scottlbaker/WSPR-beacon/README.md

## Summary

WSPR Beacon

## Description

A WSPR beacon for Arduino and Si5351.

rev0: manually set band using CAT commands

rev1: automatically set band based on band module configuration

## Contributors

* Scott L Baker

## Resources

You can check if your call was received by other stations here:
http://wsprnet.org/drupal/wsprnet/spotquery

## License

See the **LICENSE** file in this repository
