scottlbaker/WSPR-beacon/rev0/hardware/usdx-BOM.xls

Designator | Comment | Footprint | Quantity | Part Number
C1,C2,C3,C4,C5,C14 | 47uF | 8-1206 | 6 | C403725
C6,C7,C9,C10,C11,C12,C13,C15,C17 | .1uF | 3-0603 | 9 | C113803
C8,C16,C18,C19,C20,C21,C22,C23 | 10uF | 3-0603 | 8 | C344022
D1 | LED | 3-0603 | 1 | C434419
D2 | 1SMA4756 | ZENER-DO214 | 1 | C438374
D3 | SS14 | SOD123 | 1 | C2909920
J3 | USB-C | USB-C | 1 | C2765186
L2 | 100uH | 6-0805 | 1 | C223180
R1,R3 | 10.0K | 3-0603 | 2 | C191318
R2 | 1K | 3-0603 | 1 | C14676
R4 | 2.2K | 3-0603 | 1 | C4190
R5,R6 | 3.3K | 3-0603 | 2 | C22978
S1 | Push Button | PB1 | 1 | C221880
U1 | ATMEGA328 | ATMEG328 | 1 | C14877
U3 | 74ACT244 | TSSOP-20 | 1 | C6930
U4 | Si5351A | MSOP-10 | 1 | C1509083
U5 | XC6206-3.3 | SOT23-3 | 1 | C347376
U6 | CH340E | MSOP-10 | 1 | C99652
U7 | AMS1117-5 | SOT-223 | 1 | C6187
Y1 | 16MHz | Xtal_SMT1 | 1 | C13738
Y2 | 25MHz | Xtal_SMT | 1 | C9006
