scottlbaker/WSPR-beacon/rev0/hardware/schematic.pdf

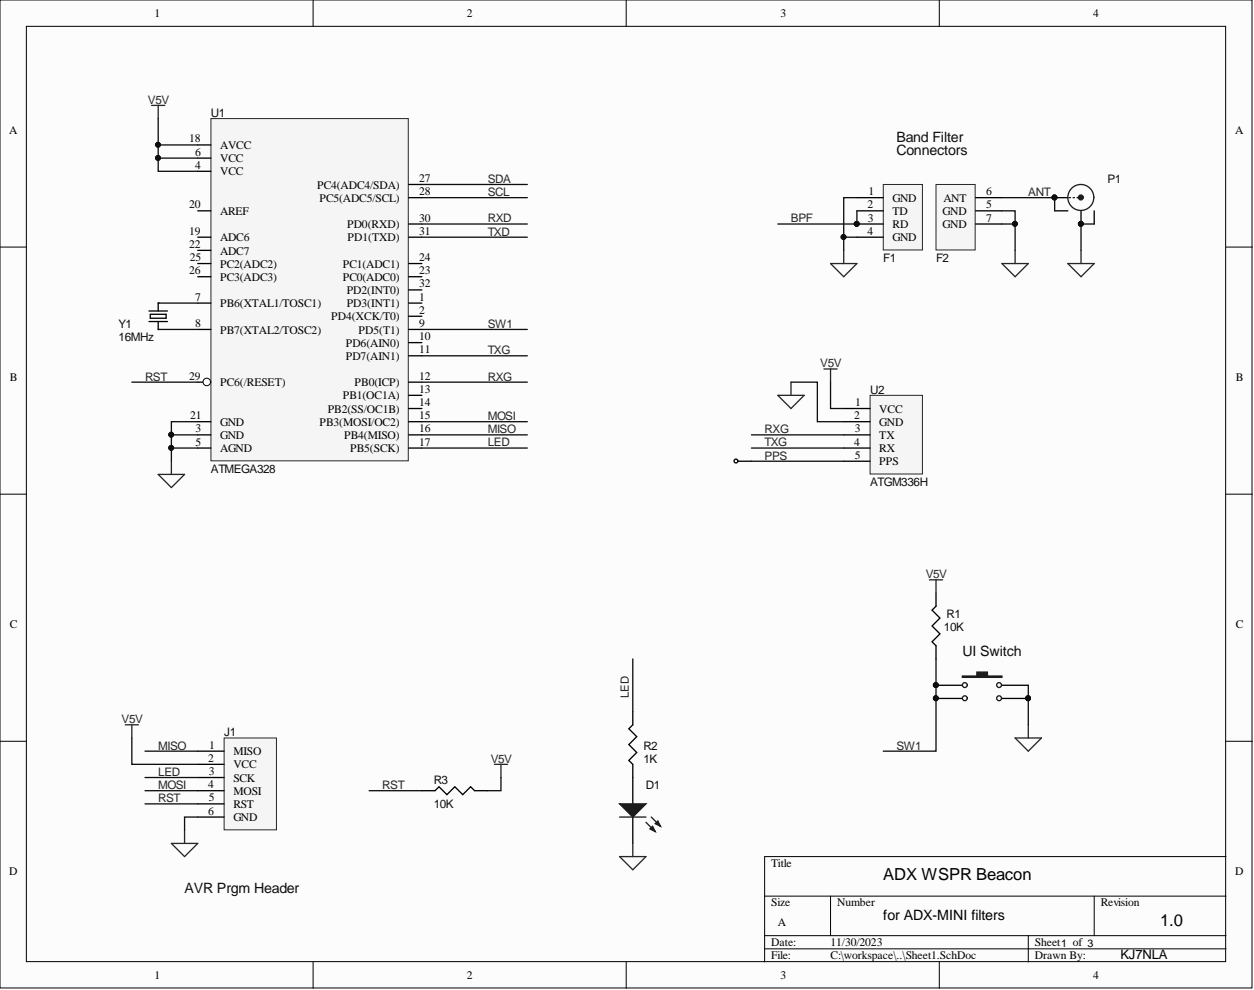
[picture p1: page 1]

GND 4

for ADX-MINI filters

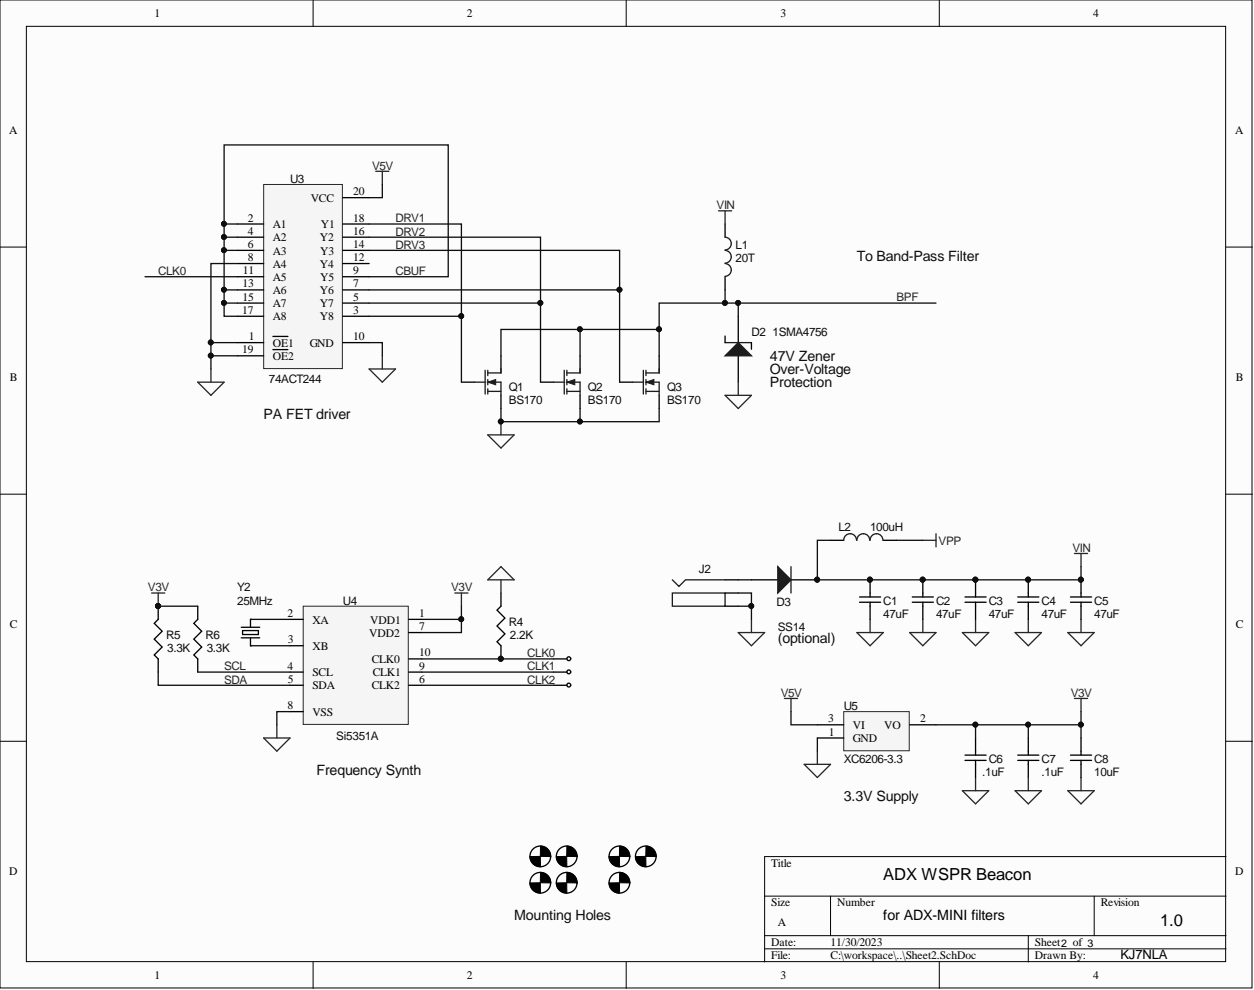
[picture p2: page 2]

To Band-Pass Filter

D2 1SMA4756
47V Zener Over-Voltage Protection

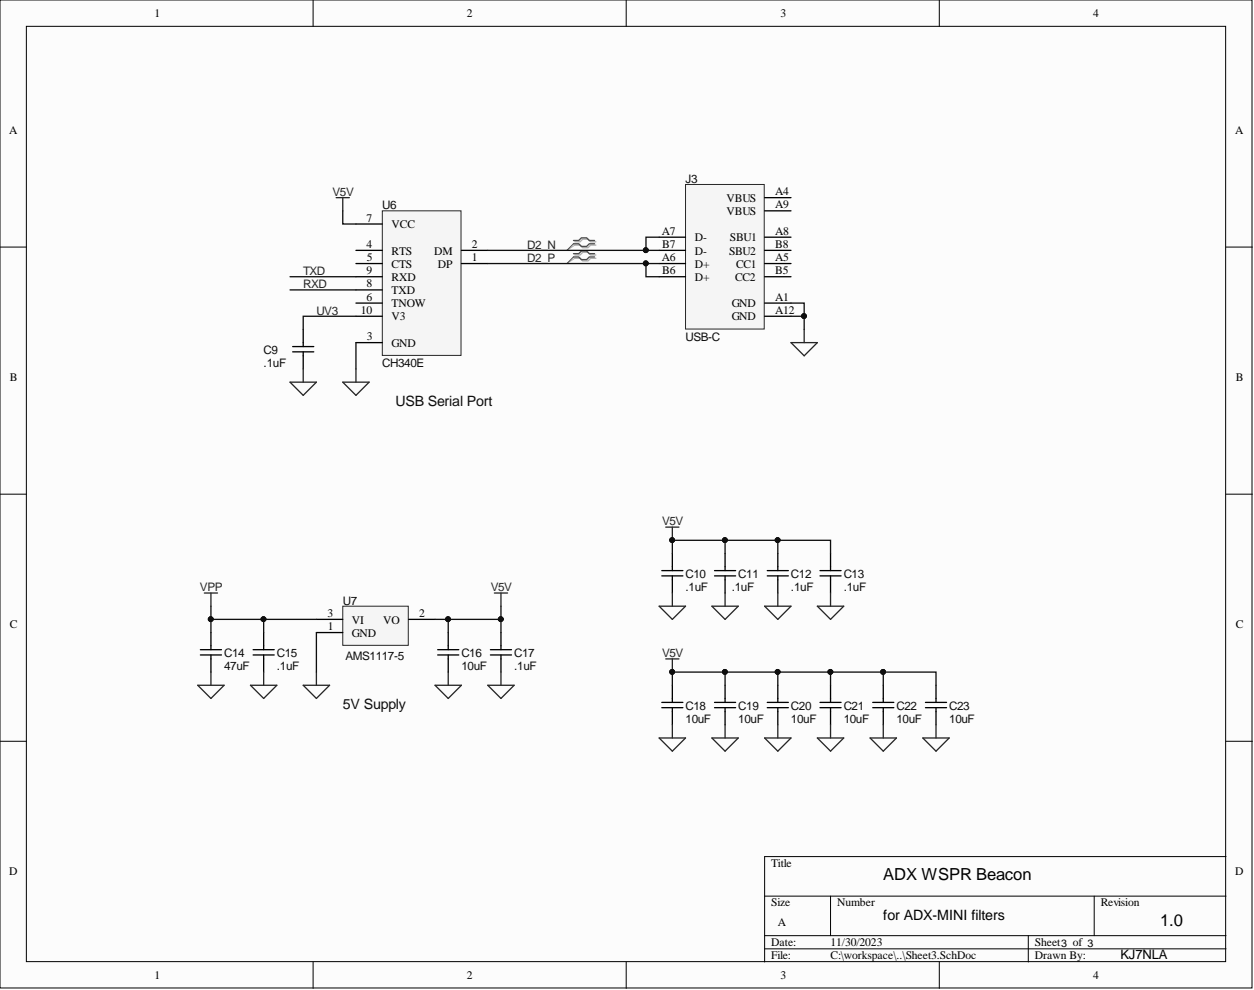
[picture p3: page 3]

TXD 8 RXD 9 CTS 5 RTS 4 | D2_P | D+ A6
